nadmansamin/SAP-1-Architecture-Implementation-Simple-Computer-Design-Project-/(list of files, drawings)

Other design files:
Proteus_File/PHASE_A.pdsprj
Proteus_File/PHASE_B.pdsprj
Proteus_File/PHASE_C.pdsprj
Proteus_File/PHASE_D_FINAL.pdsprj
